KNN-07/macropad-rp2040-easyeda/docs/images/prototype-3d.png

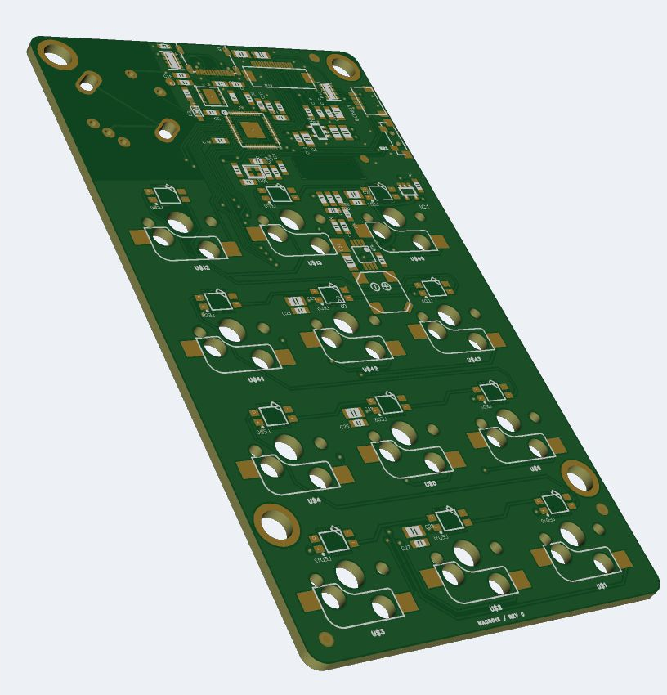
docs/images/prototype-3d.png
