KNN-07/macropad-rp2040-easyeda/hardware/3d/source/5128 MacroPad RP2040-Assembly.step

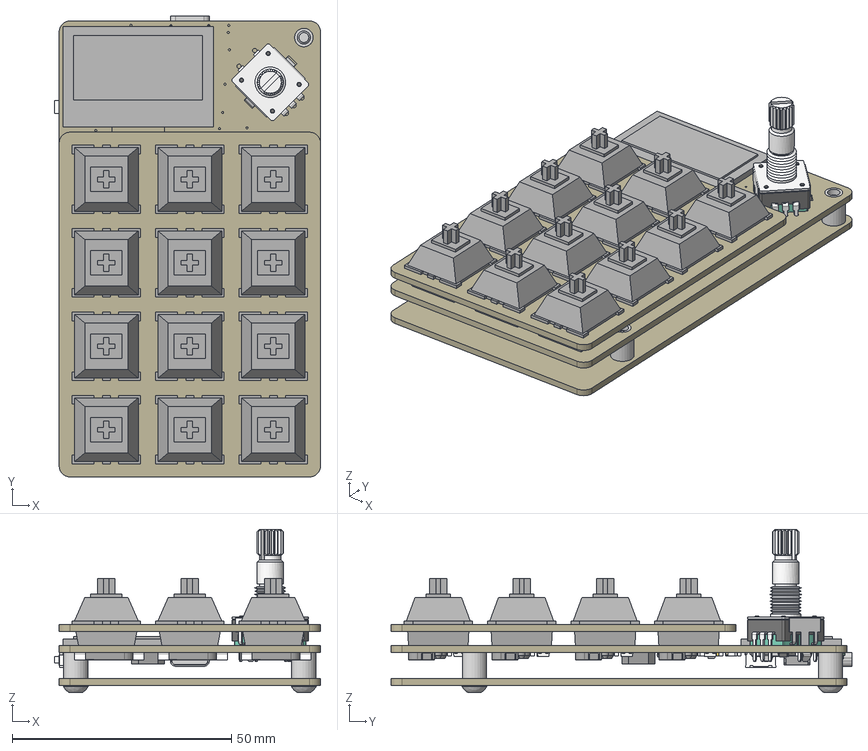
[picture p6: CAD file, 2026-10-22]
hardware/3d/source/5128 MacroPad RP2040-Assembly.step
60.8 x 105.2 x 37.3 mm
Board
Board_1
SOCKET x 12
10uF x 9
RED
AP2112K-3.3
74HCT1G125DBV
GD25x16
0.1uF x 33
RP2040_QFN56
12MHZ
TYPE C
PEC11
WS2812B_SK6812E x 12
RA SW
STEMMA_I2C_QT
1N4148
ZJY130-2864KSWLG22
5.1K x 2
7.5mm SPK
PAM8301
M3 SMT8mm x 4
Switchces
cherry mx x 12
Board_2
M3x6mm x 4
