KNN-07/macropad-rp2040-easyeda/(list of files, cad)

Other CAD files:
hardware/3d/MACRO12-RevC-assembled.blend
