KNN-07/macropad-rp2040-easyeda/(list of files, drawings)

Other design files:
hardware/easyeda/MACRO12-RevC.epro
