KNN-07/macropad-rp2040-easyeda/(commit log)

2026-10-22 Release MACRO12 Rev C prototype fabrication design
    [Adafruit MacroPad 2040 rev D.brd, Adafruit MacroPad 2040 rev D.sch, BOM-reference.csv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]
2026-10-22 Add native Rev C 3D prototype render to README
2026-10-22 Show assembled Rev C prototype with editable CAD render sources
    [5128 MacroPad RP2040-Assembly.step, MACRO12-RevC-assembled.blend]
