KNN-07/macropad-rp2040-easyeda/(notices)

Notices in the files:
firmware/qmk/keyboards/knn07/macropad_rev_c/config.h:
This program is free software: you can redistribute it and/or modify
it under the terms of the GNU General Public License as published by
the Free Software Foundation, either version 2 of the License, or
(at your option) any later version.
parts and their libraries:
microbuilder: This work is placed in the public domain, and may be freely used for commercial and non-commercial work with the following conditions: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
